msx-solis/omega_mainboard1.4eu/Mainboard_KiCad/Omega-Mainboard-Schematic-1.3eu.pdf

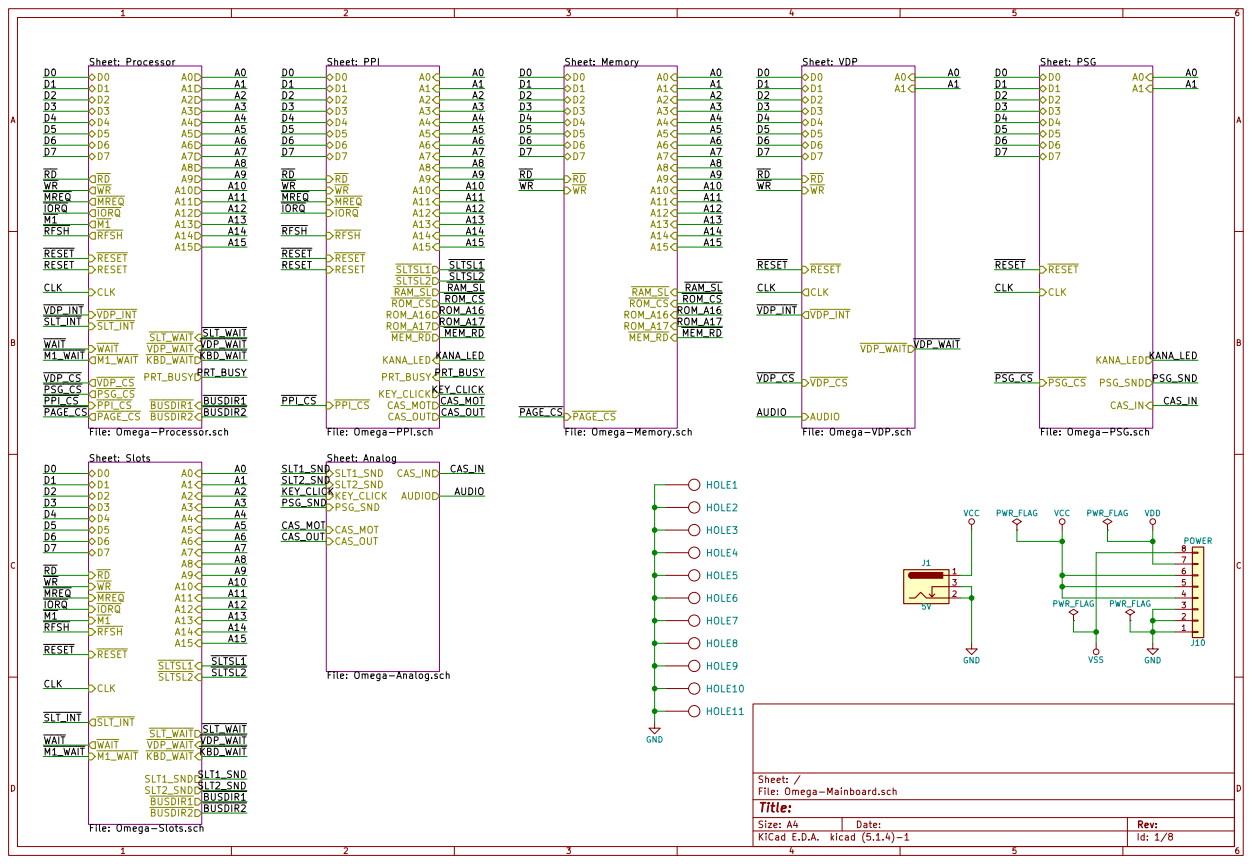
[picture p1: page 1]

File: Omega-Processor.sch A0A1A2A3A4A5A6A7A8A9 A10 A11 A12 A13 A14 A15 D0 D1 D2 D3 D4 D5 D6 D7 RDWR MREQ

SLT_WAIT
File: Omega-Slots.schA0A1A2A3A4A5A6A7A8A9 A10 A11 A12 A13 A14 A15 D0 D1 D2 D3 D4 D5 D6 D7 RDWR MREQ

File: Omega-PSG.sch

File: Omega-Analog.sch

File: Omega-Mainboard.sch Sheet: /
Id: 1/8 Title:

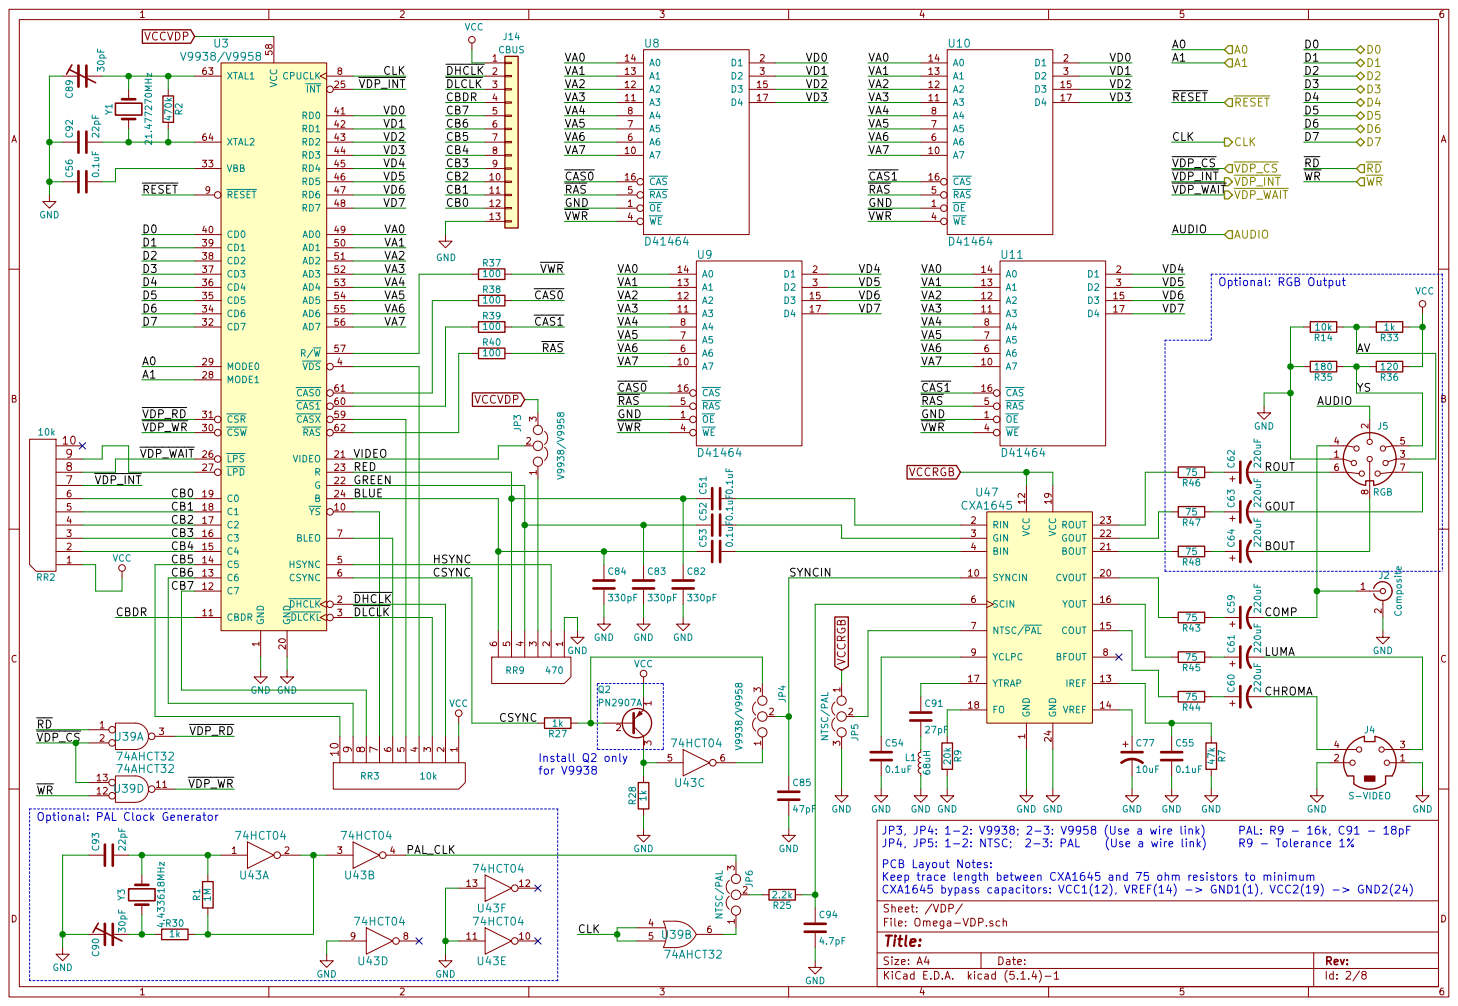
[picture p2: page 2]

1 YS 10 CBDR 11 C7 12 C6 13 C5 14 C4 15 C3 16 C2 17 C1 18 C0 19 DHCLK 2 GND 20 VIDEO 21 G

2 J2 Composite GND GND GND

PCB Layout Notes: CXA1645 bypass capacitors: VCC1(12), VREF(14) -> GND1(1), VCC2(19) -> GND2(24)

Keep trace length between CXA1645 and 75 ohm resistors to minimum

File: Omega-VDP.sch Sheet: /VDP/ 1

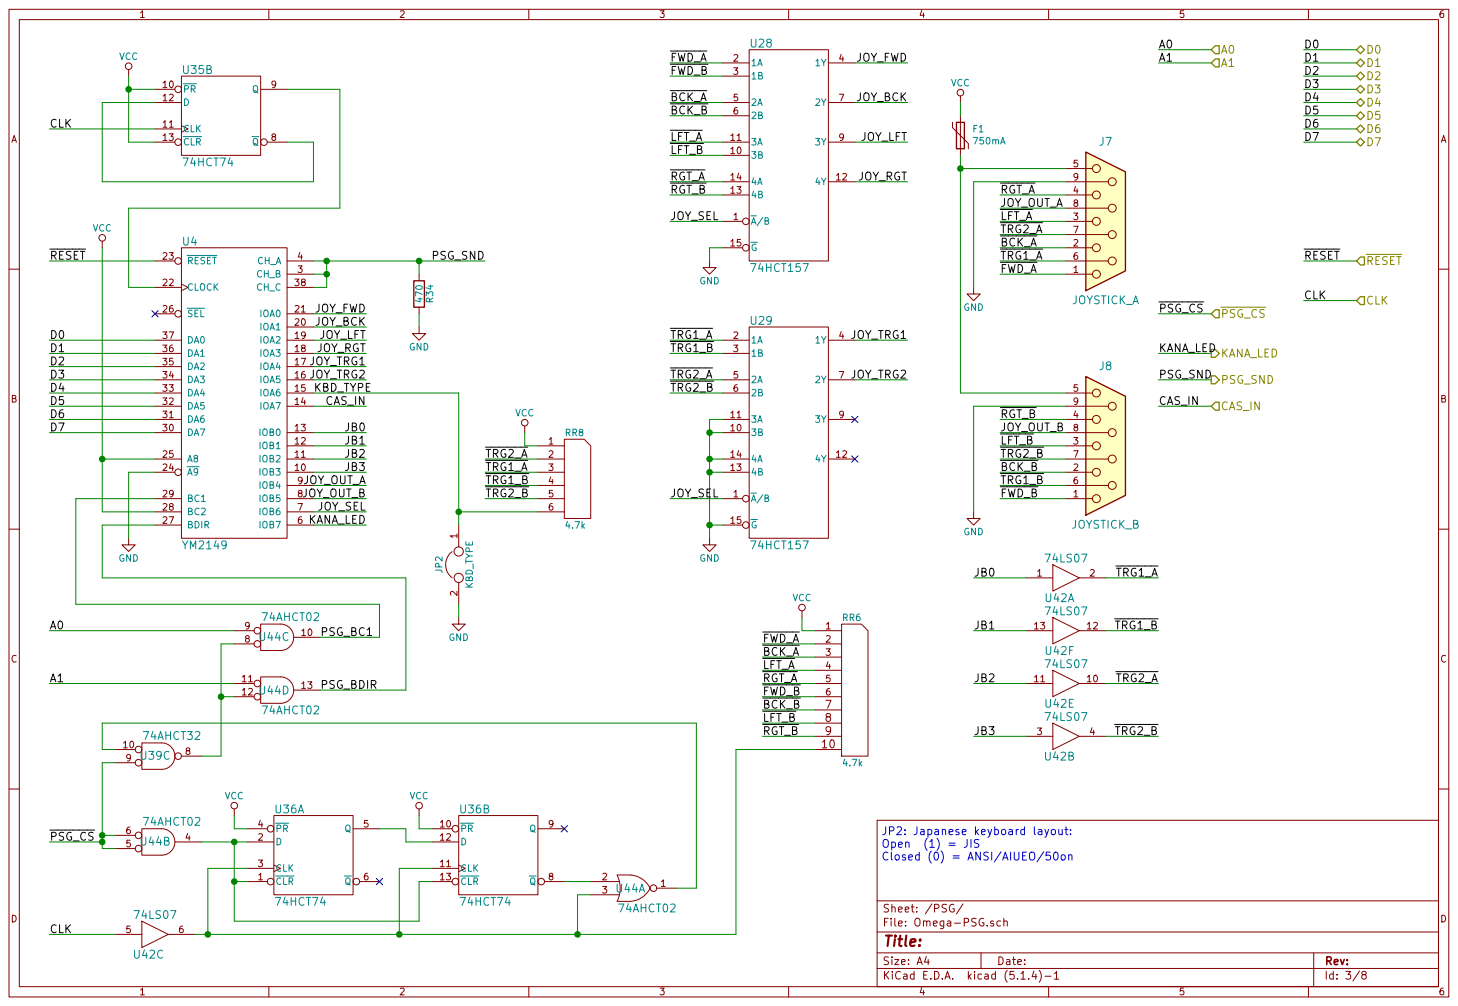
[picture p3: page 3]

74HCT157 GND
File: Omega-PSG.sch Sheet: /PSG/ 470 R34

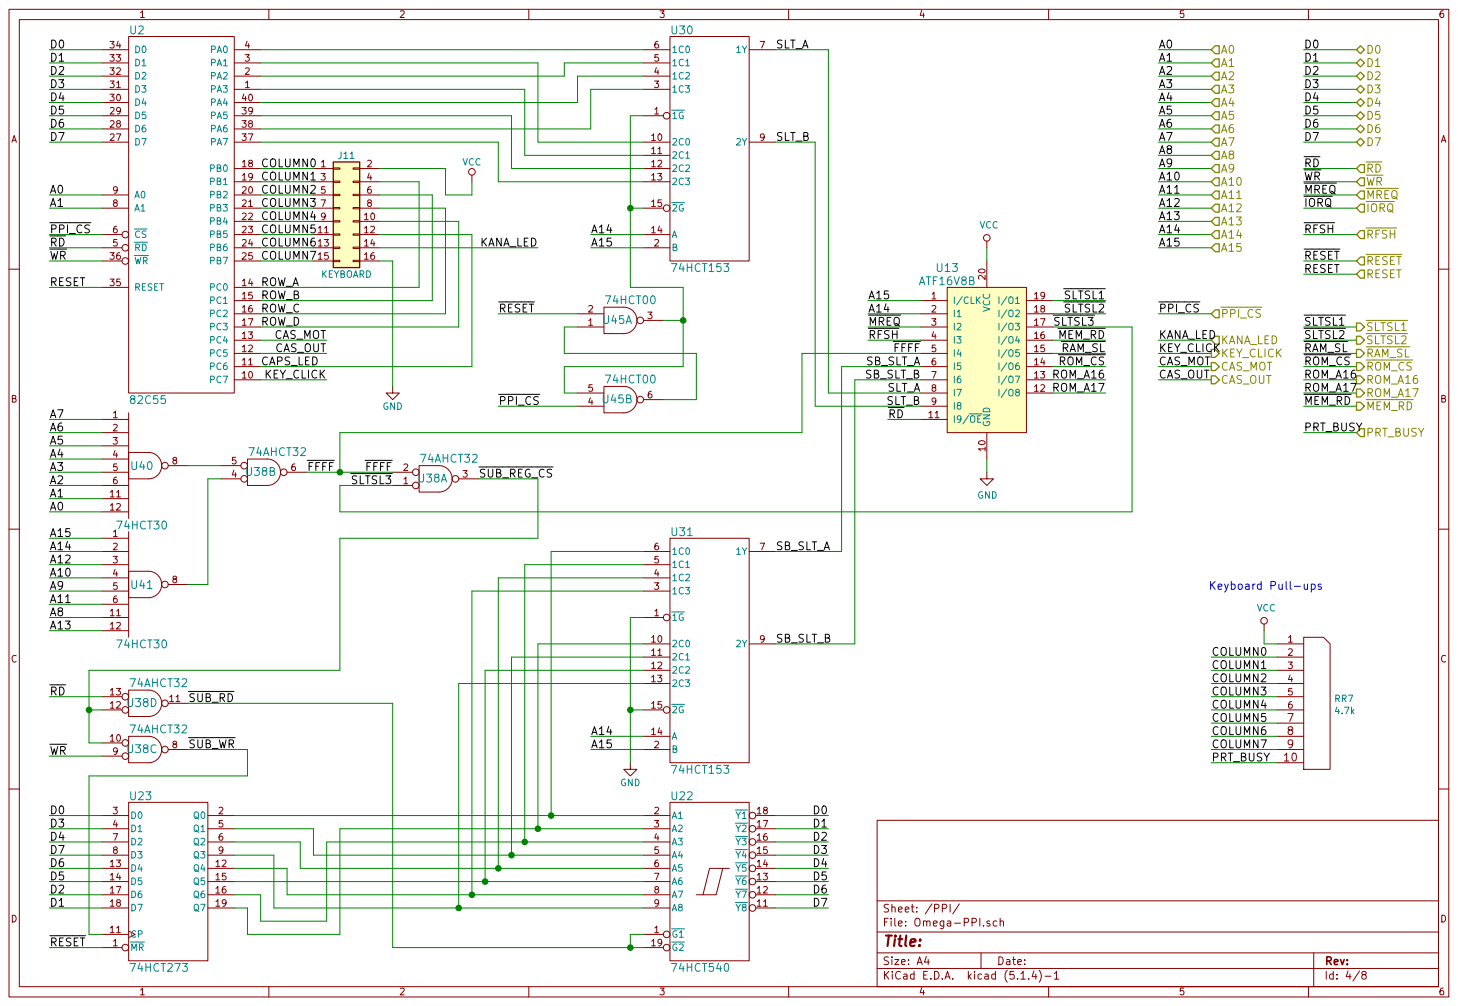
[picture p4: page 4]

COLUMN3 | 7 | 8

COLUMN5 | 11 | 12

1C1 5 | SB_SLT_B
1C2 4
1C3 3

2C1 11
2C2 12

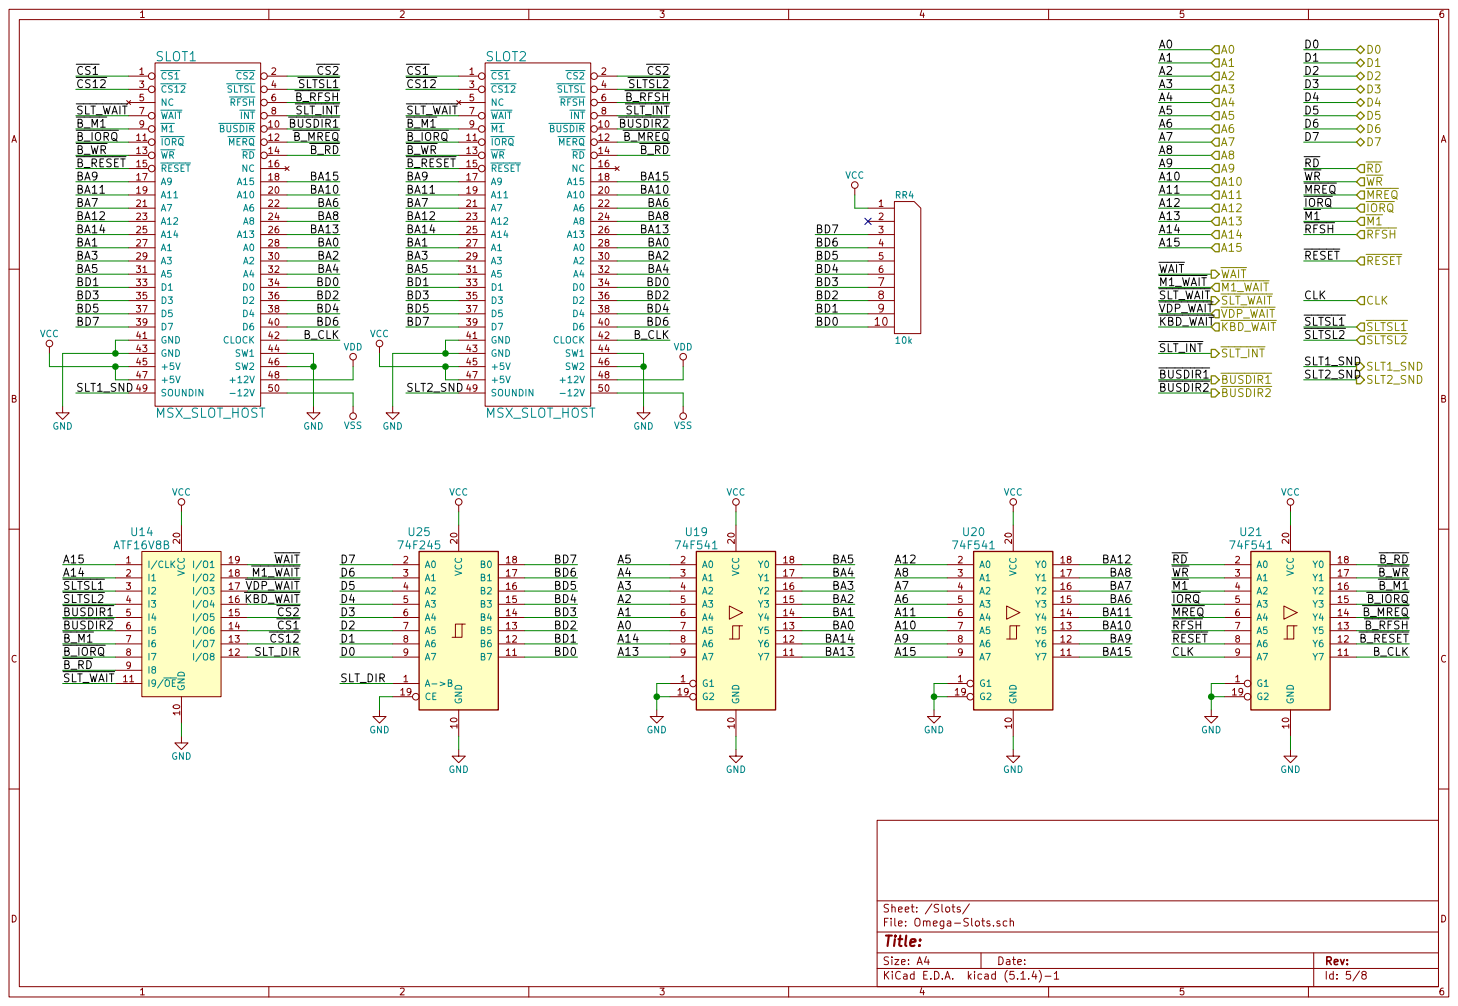
[picture p5: page 5]

File: Omega-Slots.sch Sheet: /Slots/
Id: 5/8 Title:

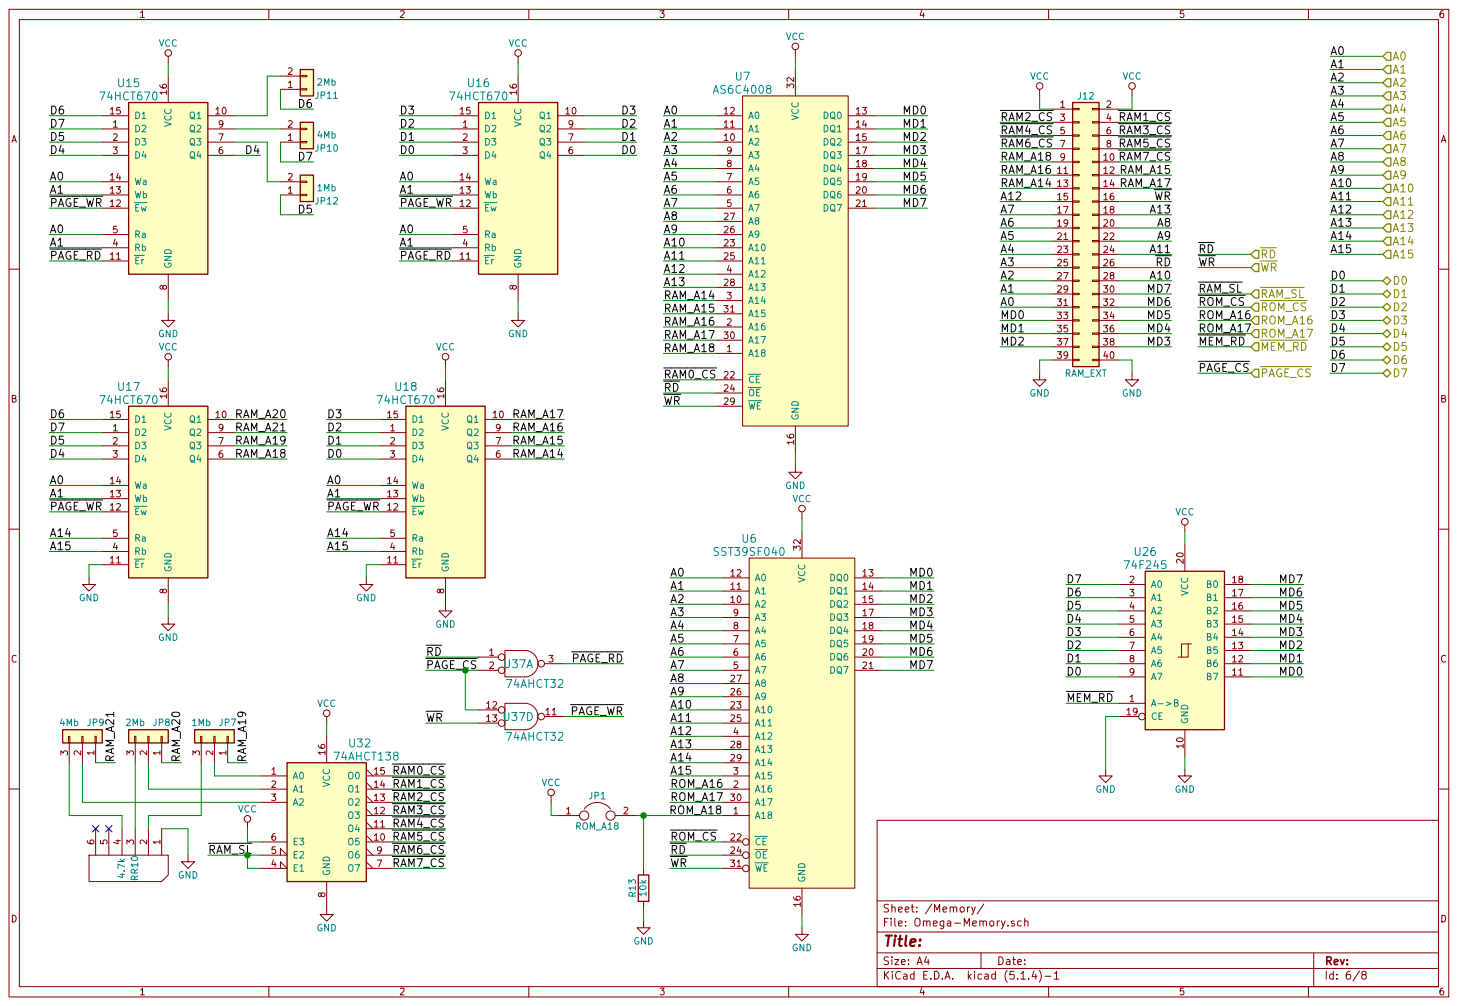
[picture p6: page 6]

File: Omega-Memory.sch
Id: 6/8 Title:

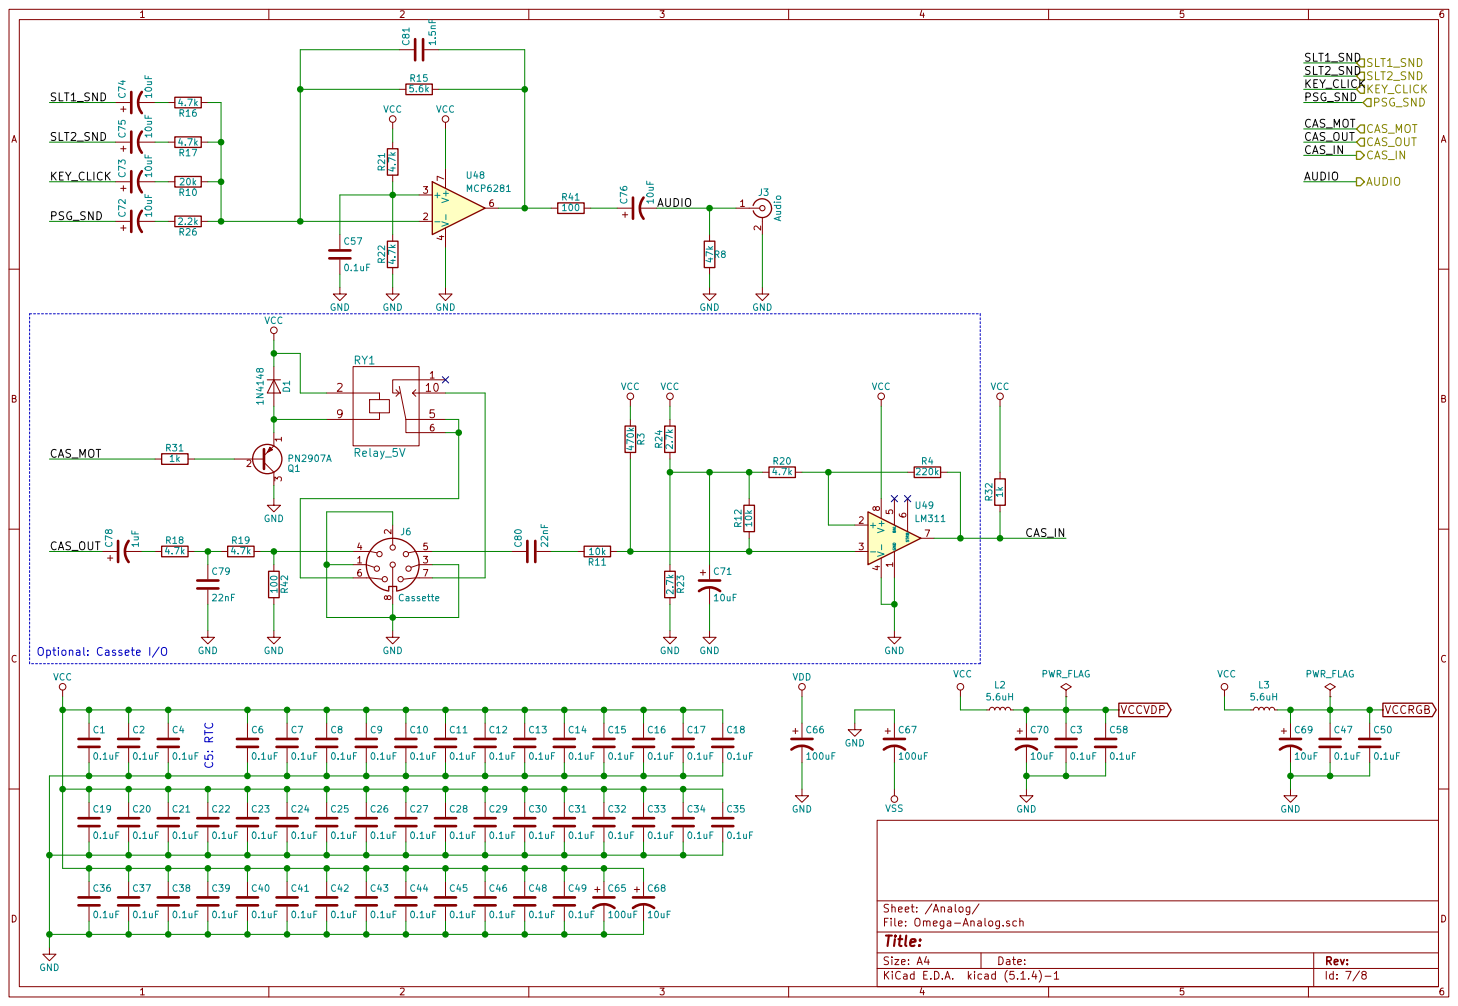
[picture p7: page 7]

File: Omega-Analog.sch
Id: 7/8 Title:

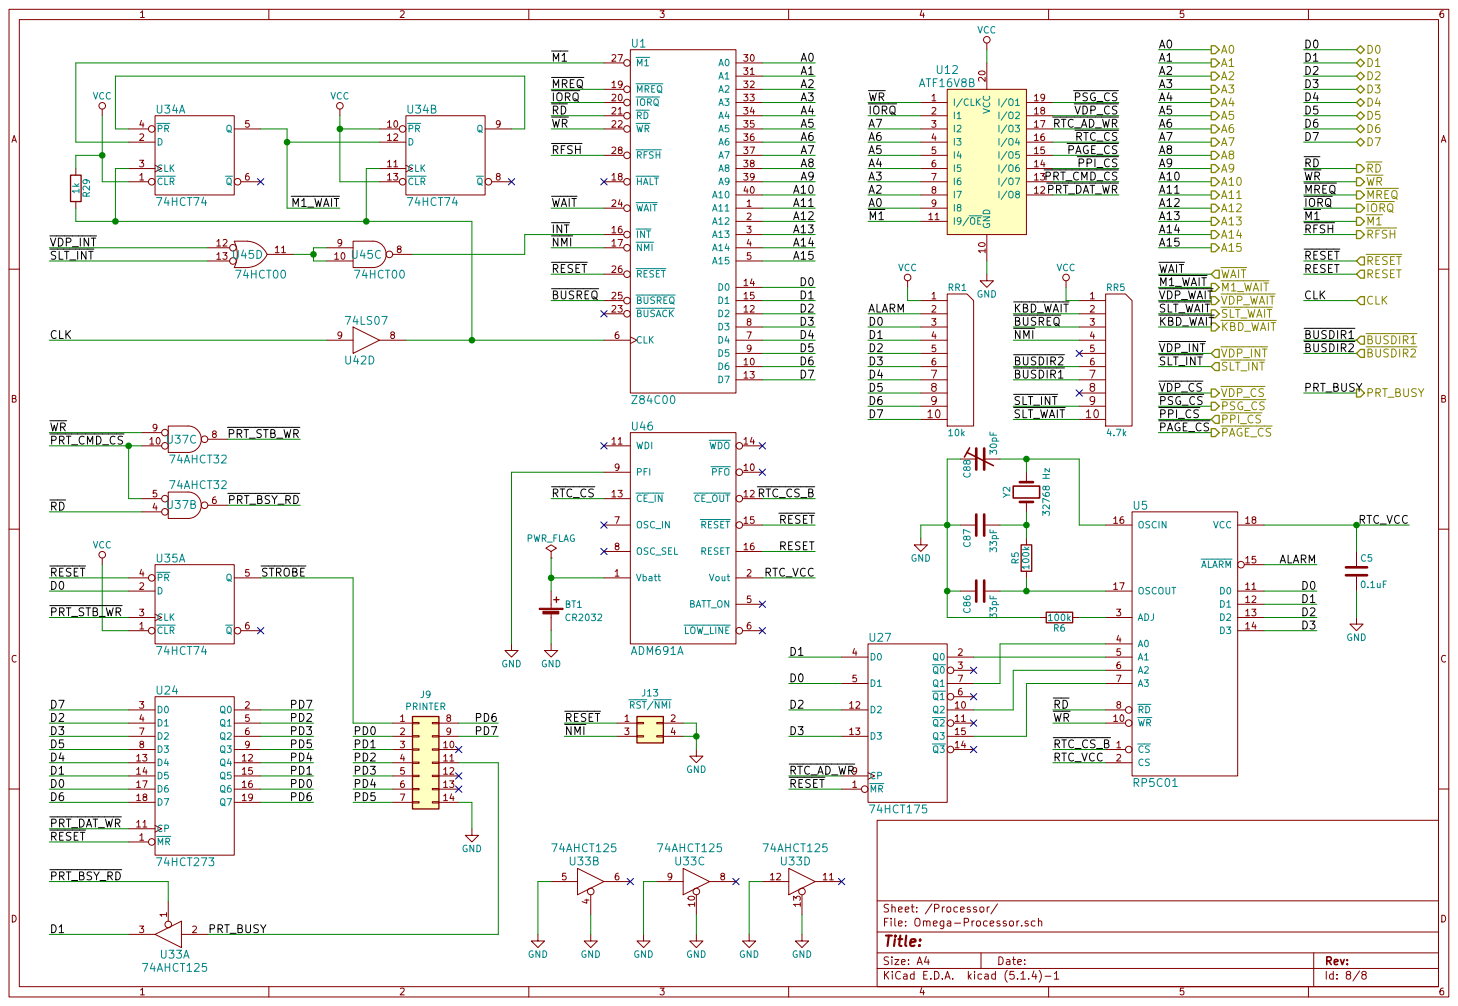
[picture p8: page 8]

File: Omega-Processor.sch Sheet: /Processor/ GND
