msx-solis/omega_mainboard1.4eu/Keyboard1.1_KiCad/Omega-Keyboard.kicad_pcb

## KiCad design Keyboard1.1_KiCad/Omega-Keyboard.kicad_pcb (2021-05-01)

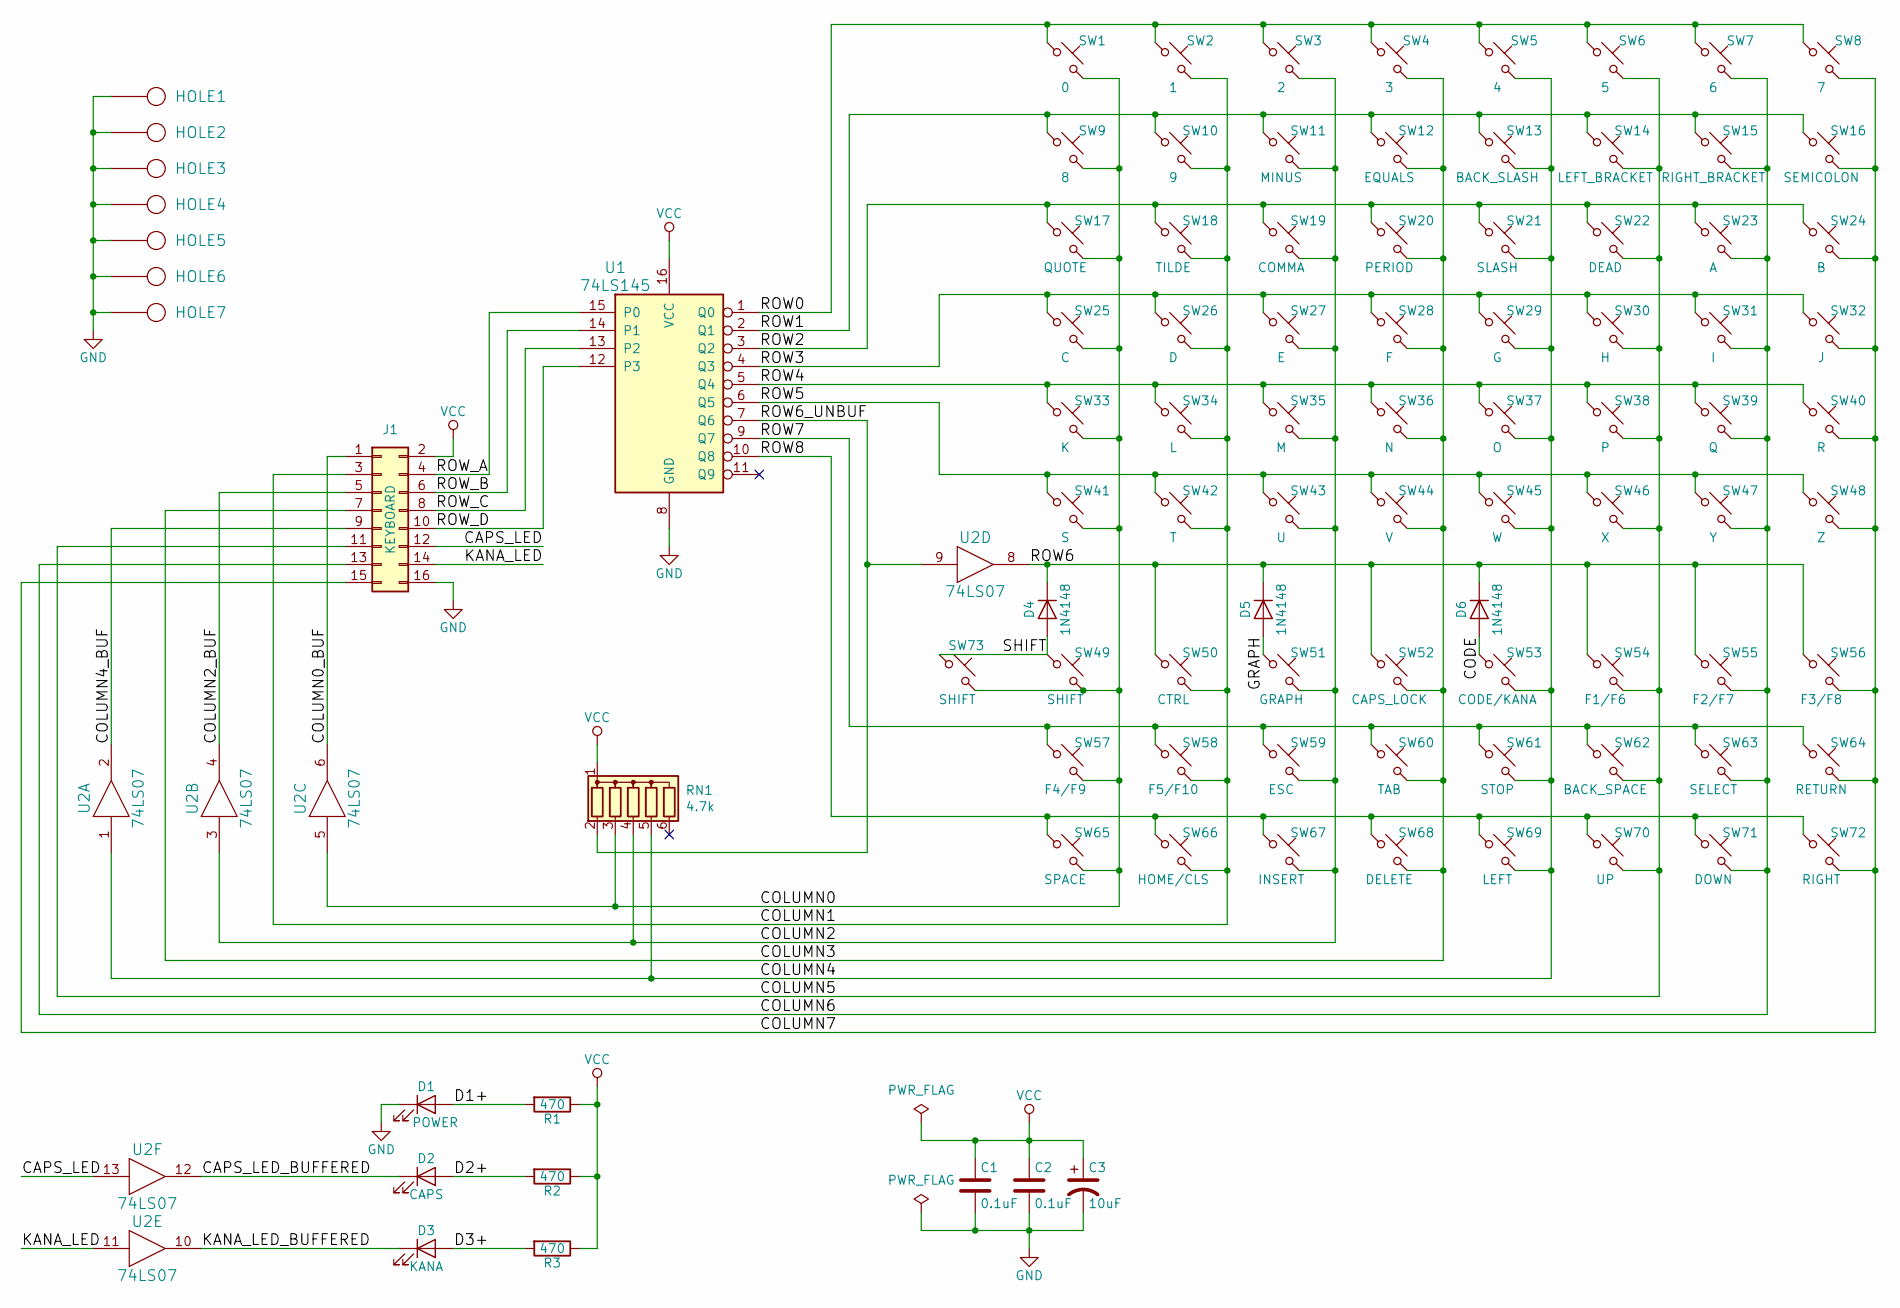
[picture p18: schematic Omega-Keyboard.sch]

Parts:
C1, C2: 0.1uF; Cap_Cer_508
C3: 10uF; Cap_Tant_508
D1: POWER; LED_3mm
D2: CAPS; CHERRY_MX_LED
D3: KANA; CHERRY_MX_LED
D4, D5, D6: 1N4148; Diode_762
HOLE1, HOLE2, HOLE3, HOLE4, HOLE5, HOLE6, HOLE7: HOLE; Hole_3mm
J1: KEYBOARD; Conn_Pin_Header_8x2_2.54mm
R1, R2, R3: 470; Res_762
RN1: 4.7k; Conn_SIL6
SW1: 0; CHERRY_PCB_100H
SW2: 1; CHERRY_PCB_100H
SW3: 2; CHERRY_PCB_100H
SW4: 3; CHERRY_PCB_100H
SW5: 4; CHERRY_PCB_100H
SW6: 5; CHERRY_PCB_100H
SW7: 6; CHERRY_PCB_100H
SW8: 7; CHERRY_PCB_100H
SW9: 8; CHERRY_PCB_100H
SW10: 9; CHERRY_PCB_100H
SW11: MINUS; CHERRY_PCB_100H
SW12: EQUALS; CHERRY_PCB_100H
SW13: BACK_SLASH; CHERRY_PCB_150H
SW14: LEFT_BRACKET; CHERRY_PCB_100H
SW15: RIGHT_BRACKET; CHERRY_PCB_100H
SW16: SEMICOLON; CHERRY_PCB_100H
SW17: QUOTE; CHERRY_PCB_100H
SW18: TILDE; CHERRY_PCB_100H
SW19: COMMA; CHERRY_PCB_100H
SW20: PERIOD; CHERRY_PCB_100H
SW21: SLASH; CHERRY_PCB_100H
SW22: DEAD; CHERRY_PCB_125H
SW23: A; CHERRY_PCB_100H
SW24: B; CHERRY_PCB_100H
SW25: C; CHERRY_PCB_100H
SW26: D; CHERRY_PCB_100H
SW27: E; CHERRY_PCB_100H
SW28: F; CHERRY_PCB_100H
SW29: G; CHERRY_PCB_100H
SW30: H; CHERRY_PCB_100H
SW31: I; CHERRY_PCB_100H
SW32: J; CHERRY_PCB_100H
SW33: K; CHERRY_PCB_100H
SW34: L; CHERRY_PCB_100H
SW35: M; CHERRY_PCB_100H
SW36: N; CHERRY_PCB_100H
SW37: O; CHERRY_PCB_100H
SW38: P; CHERRY_PCB_100H
SW39: Q; CHERRY_PCB_100H
SW40: R; CHERRY_PCB_100H
SW41: S; CHERRY_PCB_100H
SW42: T; CHERRY_PCB_100H
SW43: U; CHERRY_PCB_100H
SW44: V; CHERRY_PCB_100H
SW45: W; CHERRY_PCB_100H
SW46: X; CHERRY_PCB_100H
SW47: Y; CHERRY_PCB_100H
SW48: Z; CHERRY_PCB_100H
SW49: SHIFT; CHERRY_PCB_225H
SW50: CTRL; CHERRY_PCB_125H
SW51: GRAPH; CHERRY_PCB_125H
SW52: CAPS_LOCK; CHERRY_PCB_175H
SW53: CODE/KANA; CHERRY_PCB_125H
SW54: F1/F6; CHERRY_PCB_100H
SW55: F2/F7; CHERRY_PCB_100H
SW56: F3/F8; CHERRY_PCB_100H
SW57: F4/F9; CHERRY_PCB_100H
SW58: F5/F10; CHERRY_PCB_100H
SW59: ESC; CHERRY_PCB_100H
SW60: TAB; CHERRY_PCB_150H
SW61: STOP; CHERRY_PCB_100H
SW62: BACK_SPACE; CHERRY_PCB_200H
SW63: SELECT; CHERRY_PCB_125H
SW64: RETURN; CHERRY_PCB_225H
SW65: SPACE; CHERRY_PCB_625H
SW66: HOME/CLS; CHERRY_PCB_100H
SW67: INSERT; CHERRY_PCB_100H
SW68: DELETE; CHERRY_PCB_100H
SW69: LEFT; CHERRY_PCB_100H
SW70: UP; CHERRY_PCB_100H
SW71: DOWN; CHERRY_PCB_100H
SW72: RIGHT; CHERRY_PCB_100H
SW73: SHIFT; CHERRY_PCB_275H
U1: 74LS145; IC_DIP16_300
U2: 74LS07; IC_DIP14_300

Connections:
/CAPS_LED: J1.12, U2.13
/CAPS_LED_BUFFERED: D2.1 (K), U2.12
/CODE: D6.2 (A), SW53.1
/COLUMN0: RN1.3 (R2), SW1.2, SW9.2, SW17.2, SW25.2, SW33.2, SW41.2, SW49.2, SW57.2, SW65.2, SW73.2, U2.5
/COLUMN0_BUF: J1.1, U2.6
/COLUMN1: J1.3, SW2.2, SW10.2, SW18.2, SW26.2, SW34.2, SW42.2, SW50.2, SW58.2, SW66.2
/COLUMN2: RN1.4 (R3), SW3.2, SW11.2, SW19.2, SW27.2, SW35.2, SW43.2, SW51.2, SW59.2, SW67.2, U2.3
/COLUMN2_BUF: J1.5, U2.4
/COLUMN3: J1.7, SW4.2, SW12.2, SW20.2, SW28.2, SW36.2, SW44.2, SW52.2, SW60.2, SW68.2
/COLUMN4: RN1.5 (R4), SW5.2, SW13.2, SW21.2, SW29.2, SW37.2, SW45.2, SW53.2, SW61.2, SW69.2, U2.1
/COLUMN4_BUF: J1.9, U2.2
/COLUMN5: J1.11, SW6.2, SW14.2, SW22.2, SW30.2, SW38.2, SW46.2, SW54.2, SW62.2, SW70.2
/COLUMN6: J1.13, SW7.2, SW15.2, SW23.2, SW31.2, SW39.2, SW47.2, SW55.2, SW63.2, SW71.2
/COLUMN7: J1.15, SW8.2, SW16.2, SW24.2, SW32.2, SW40.2, SW48.2, SW56.2, SW64.2, SW72.2
/D1+: D1.2 (A), R1.2
/D2+: D2.2 (A), R2.2
/D3+: D3.2 (A), R3.2
/GRAPH: D5.2 (A), SW51.1
/KANA_LED: J1.14, U2.11
/KANA_LED_BUFFERED: D3.1 (K), U2.10
/ROW0: SW1.1, SW2.1, SW3.1, SW4.1, SW5.1, SW6.1, SW7.1, SW8.1, U1.1 (Q0)
/ROW1: SW9.1, SW10.1, SW11.1, SW12.1, SW13.1, SW14.1, SW15.1, SW16.1, U1.2 (Q1)
/ROW2: SW17.1, SW18.1, SW19.1, SW20.1, SW21.1, SW22.1, SW23.1, SW24.1, U1.3 (Q2)
/ROW3: SW25.1, SW26.1, SW27.1, SW28.1, SW29.1, SW30.1, SW31.1, SW32.1, U1.4 (Q3)
/ROW4: SW33.1, SW34.1, SW35.1, SW36.1, SW37.1, SW38.1, SW39.1, SW40.1, U1.5 (Q4)
/ROW5: SW41.1, SW42.1, SW43.1, SW44.1, SW45.1, SW46.1, SW47.1, SW48.1, U1.6 (Q5)
/ROW6: D4.1 (K), D5.1 (K), D6.1 (K), SW50.1, SW52.1, SW54.1, SW55.1, SW56.1, U2.8
/ROW6_UNBUF: RN1.2 (R1), U1.7 (Q6), U2.9
/ROW7: SW57.1, SW58.1, SW59.1, SW60.1, SW61.1, SW62.1, SW63.1, SW64.1, U1.9 (Q7)
/ROW8: SW65.1, SW66.1, SW67.1, SW68.1, SW69.1, SW70.1, SW71.1, SW72.1, U1.10 (Q8)
/ROW_A: J1.4, U1.15 (P0)
/ROW_B: J1.6, U1.14 (P1)
/ROW_C: J1.8, U1.13 (P2)
/ROW_D: J1.10, U1.12 (P3)
/SHIFT: D4.2 (A), SW49.1, SW73.1
GND: C1.2, C2.2, C3.2, D1.1 (K), HOLE1.1, HOLE2.1, HOLE3.1, HOLE4.1, HOLE5.1, HOLE6.1, HOLE7.1, J1.16, U1.8 (GND), U2.7 (GND)
VCC: C1.1, C2.1, C3.1, J1.2, R1.1, R2.1, R3.1, RN1.1 (common), U1.16 (VCC), U2.14 (VCC)

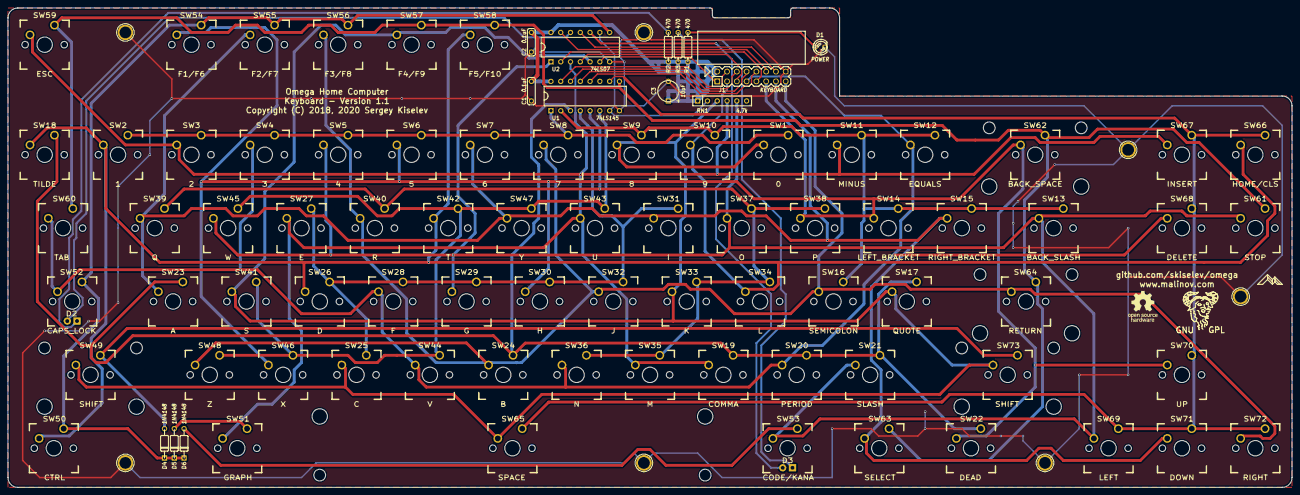
[picture p19: board Omega-Keyboard.kicad_pcb from above]

Board: 2 copper layers, 333.4 x 124.5 mm, 96 parts (0 on the bottom side), 37 nets.
