msx-solis/omega_mainboard1.4eu/(notices)

Notices in the files:
Keyboard1.1_KiCad/Omega-Keyboard.kicad_pcb:
Copyright (C) 2018, 2020 Sergey Kiselev
Mainboard_KiCad/Omega-Mainboard.kicad_pcb:
Copyright (C) 2018-2021 Sergey Kiselev
